fabse-hack/water.rocket/photos_animations/trigger2.jpg

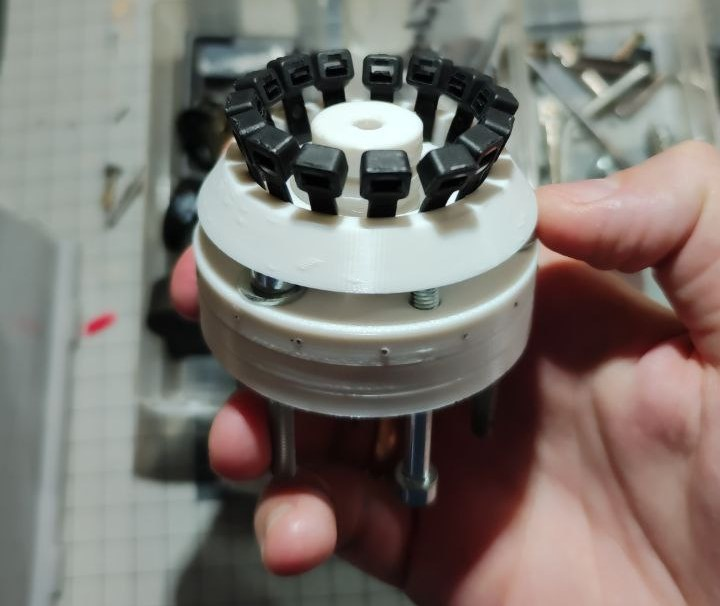
photos_animations/trigger2.jpg
