fabse-hack/water.rocket/(list of files, drawings)

Other design files:
wiring.fzz
